gcormier/esphome-pressure/modules/hybrid/stackup.png

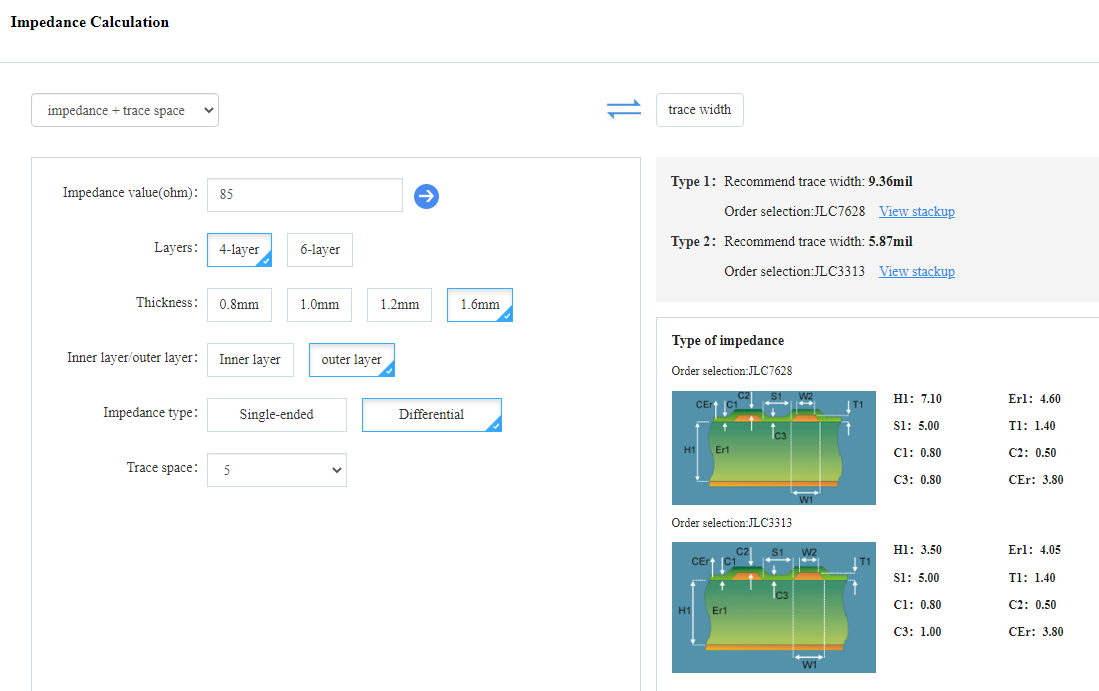
modules/hybrid/stackup.png
