gcormier/esphome-pressure/modules/hybrid/SDP810.step

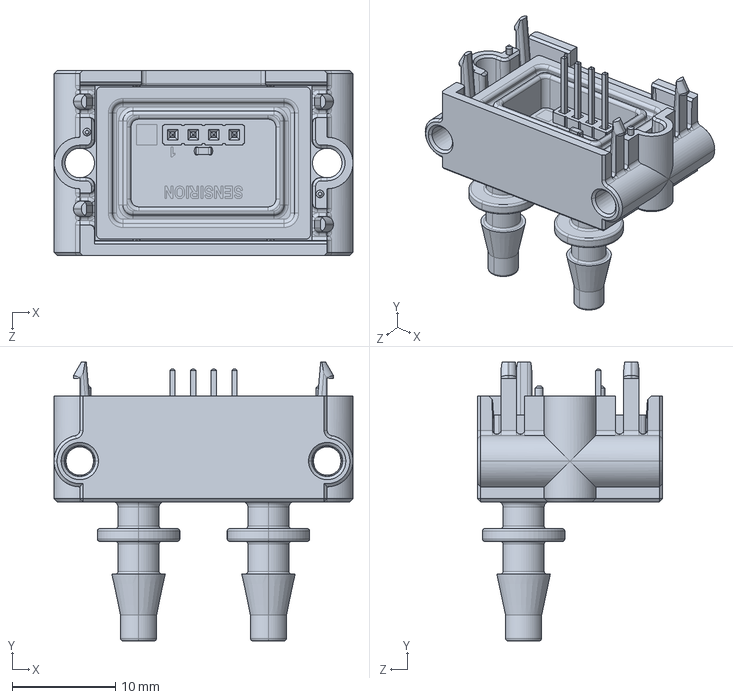
[picture p3: CAD file, 2026-10-07]
modules/hybrid/SDP810.step
29.0 x 27.1 x 18.0 mm
