gcormier/esphome-pressure/pcb/enclosurepanel/HoseSketch.dxf

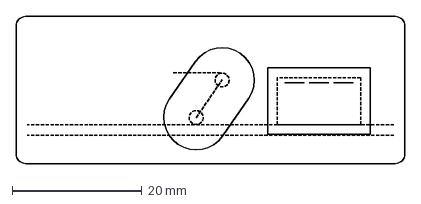
[picture p4: CAD file, 2024-12-11]
pcb/enclosurepanel/HoseSketch.dxf
60.0 x 22.7 mm
