gcormier/esphome-pressure/modules/hybrid/6899.STEP

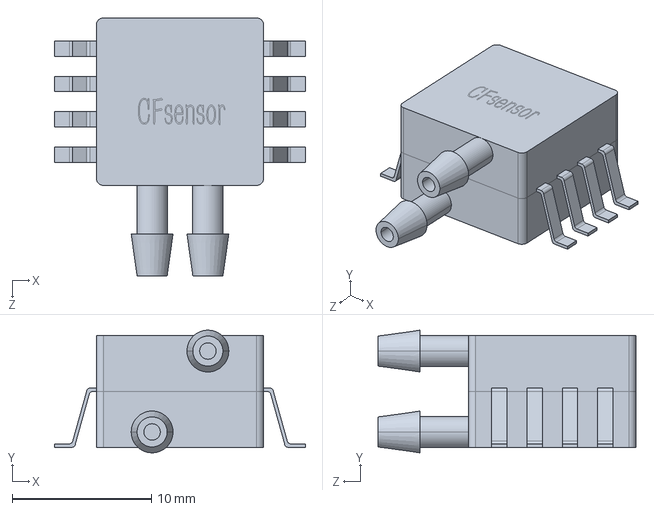
[picture p5: CAD file, 2023-09-27]
modules/hybrid/6899.STEP
18.0 x 8.80 x 18.5 mm
