gcormier/esphome-pressure/pcb/enclosurepanel/PowerSketch.dxf

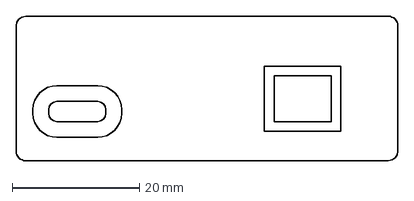
[picture p6: CAD file, 2024-12-11]
pcb/enclosurepanel/PowerSketch.dxf
60.0 x 22.7 mm
