gcormier/esphome-pressure/pcb/HC-SFP-20P--3DModel-STEP-56544.STEP

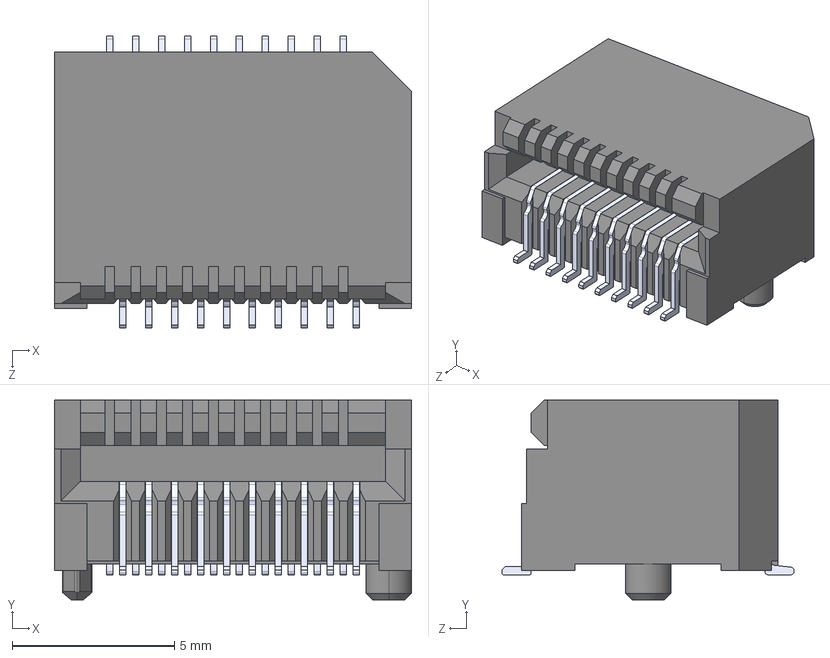
[picture p7: CAD file, 2026-10-07]
pcb/HC-SFP-20P--3DModel-STEP-56544.STEP
11.0 x 6.15 x 9.00 mm
HC-SFP-20P
pins^HC-SFP-20P Ass x 10
