gcormier/esphome-pressure/pcb/6897.STEP

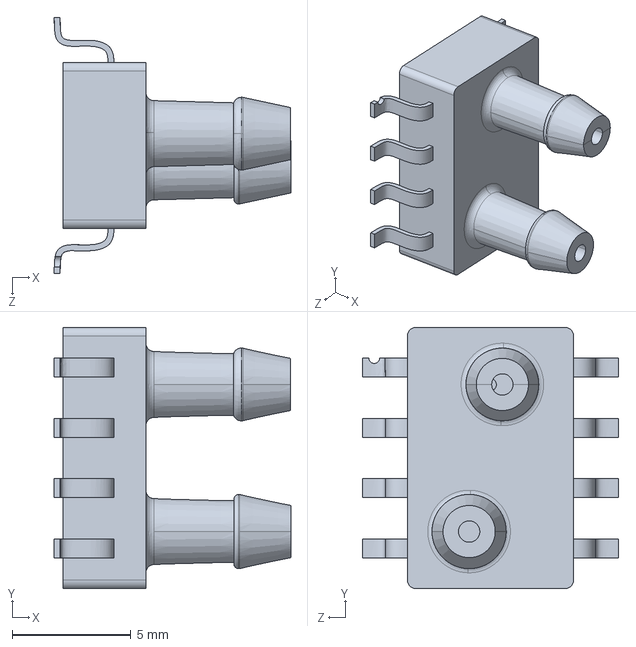
[picture p8: CAD file, 2023-09-27]
pcb/6897.STEP
9.97 x 11.0 x 10.8 mm
