gcormier/esphome-pressure/pcb/enclosurepanel/plate-power.dxf

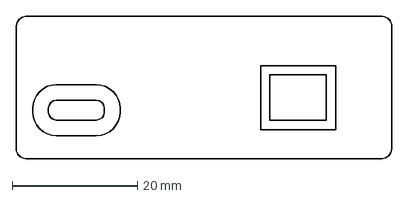
[picture p9: CAD file, 2023-12-01]
pcb/enclosurepanel/plate-power.dxf
60.0 x 22.7 mm
