gcormier/esphome-pressure/(threads)

Thread 3 (2024-04-25):

What size of tubing should be used?

LukeTowers, 2024-04-25:
What size of tubing is needed and do you have any recommendations for where to source it from?

gcormier, 2024-04-26:
The biggest part of the barb is 3mm in diameter. So if you are using a stiffer tuber, it should be close to that for the ID. If you are using a soft material, it can probably be a bit smaller.

I bought mine from homedepot - I would bring the device to your local store to see what fits best, I would hate to recommend something that doesn't fit :) I no longer have the packing for mine. it is a clear, fairly stiff, tube. Next time I would probably splurge on something softer like silicone perhaps, but it doesn't matter in the end since it is static pressure so there is no airflow.

kramttocs, 2024-07-15:
I ordered Pure Silicone Tubing 1/16 ID x 1/8 OD and it fit well.

gcormier, 2024-07-16:
Now covered in the readme - https://github.com/gcormier/esphome-pressure?tab=readme-ov-file#hosetubing

kramttocs, 2024-07-19:
Actually, I retract my 1/16 suggestion. It does work but it is tough to connect to the common 1/8 fittings.
Ordered this and it works much better:

Quickun Pure Silicone Tubing, 2mm ID x 4mm OD High Temp Food Grade Tube Pure Silicone Hose Tube for Home Brewing, Beer Line, Kegerator, Wine Making, Aquaponics, Air Hose by Proper Pour (16.4 Ft)

gcormier, 2024-07-20:
thx have modified readme

Closed 2024-07-16.

Thread 4 (2024-05-06):

I2C not reporting on Esphome?

benhoff, 2024-05-06:
Hey I have the following for the yaml with esphome:

``` yaml
i2c:
  sda: 6
  scl: 7
  scan: true
  id: bus_a

sensor:
  - platform: xgzp68xx
    temperature:
      name: "Pressure Temperature"
    pressure:
      name: "Pressure Diff pressure"
    update_interval: 5s
```

However, I'm not seeing the DP sensor in esphome/home assistant.
Are the pinout assignments on here correct or anything else I should look into?

gcormier, 2024-05-06:
That should work - what do the logs look like?

benhoff, 2024-05-06:
They look with the exception of not having an I2C sensor in them:

``` log
[I][app:029]: Running through setup()...
[C][wifi:038]: Setting up WiFi...
[C][wifi:051]: Starting WiFi...
[C][wifi:052]:   Local MAC: D4:F9:8D:09:D8:F0
[D][wifi:462]: Starting scan...
[W][component:157]: Component wifi set Warning flag: unspecified
[D][wifi:477]: Found networks:
[I][wifi:521]: - 'ShenHousehold' [redacted]▂▄▆█
[D][wifi:522]:     Channel: 1
[D][wifi:523]:     RSSI: -40 dB
[I][wifi:521]: - 'ShenHousehold' [redacted]▂▄▆█
[D][wifi:522]:     Channel: 11
[D][wifi:523]:     RSSI: -78 dB
[D][wifi:526]: - [redacted] [redacted]▂▄▆█
[D][wifi:526]: - [redacted] [redacted]▂▄▆█
[D][wifi:526]: - [redacted] [redacted]▂▄▆█
[D][wifi:526]: - [redacted] [redacted]▂▄▆█
[D][wifi:526]: - [redacted] [redacted]▂▄▆█
[D][wifi:526]: - [redacted] [redacted]▂▄▆█
[D][wifi:526]: - [redacted] [redacted]▂▄▆█
[D][wifi:526]: - [redacted] [redacted]▂▄▆█
[D][wifi:526]: - [redacted] [redacted]▂▄[D][wifi:526]: - [redacted] [redacted][D][wifi:526]: - [redacted] [redacted]▂▄▆█
[D][wifi:526]: - [redacted] [redacted]▂▄ [D][wifi:526]: - [redacted] [redacted]▂▄▆█
[D][wifi:526]: - [redacted] [redacted]▂▄▆█[D][wifi:526]: - [redacted] [redacted][D][wifi:526]: - [redacted] [redacted]▂▄▆█
[D][wifi:526]: - [redacted] [redacted]▂▄▆█
[D][wifi:526]: - [redacted] [redacted]▂▄▆█
[D][wifi:526]: - [redacted] [redacted]0;36m[D][wifi:526]: - [redacted] [redacted] [D][wifi:526]: - [redacted] [redacted]▂▄▆█
[D][wifi:526]: - [redacted] [redacted]▂▄0;36m[D][wifi:526]: - [redacted] [redacted]▂▄▆█
[D][wifi:526]: - [redacted] [redacted][D][wifi:526]: - [redacted] [redacted]▂▄▆█
[D][wifi:526]: - [redacted] [redacted]▂▄�
[D][wifi:526]: - [redacted] [redacted]▂▄▆█
[D][wifi:526]: - [redacted] [redacted][D][wifi:526]: - [redacted] [redacted][D][wifi:526]: - [redacted] [redacted][I][wifi:303]: WiFi Connecting to 'ShenHousehold'...
[W][wifi_esp32:482]: Event: Disconnected ssid='ShenHousehold' bssid=[redacted] reason='Auth Expired'
[W][wifi:633]: Error while connecting to network.
[D][wifi:677]: Retrying with hidden networks...
[I][wifi:303]: WiFi Connecting to 'ShenHousehold'...
[I][wifi:597]: WiFi Connected!
[C][wifi:408]:   Local MAC: D4:F9:8D:09:D8:F0
[C][wifi:413]:   SSID: [redacted]
[C][wifi:416]:   IP Address: 192.168.1.108
[C][wifi:420]:   BSSID: [redacted]
[C][wifi:421]:   Hostname: 'hvac'
[C][wifi:423]:   Signal strength: -42 dB ▂▄▆█
[C][wifi:427]:   Channel: 1
[C][wifi:428]:   Subnet: 255.255.255.0
[C][wifi:429]:   Gateway: 192.168.1.1
[C][wifi:430]:   DNS1: 192.168.1.62
[C][wifi:431]:   DNS2: 192.168.1.182
[D][wifi:606]: Disabling AP...
[C][ota:096]: Over-The-Air Updates:
[C][ota:097]:   Address: hvac.local:3232
[C][ota:100]:   Using Password.
[C][ota:103]:   OTA version: 2.
[C][api:025]: Setting up Home Assistant API server...
[I][app:062]: setup() finished successfully!
[W][component:170]: Component wifi cleared Warning flag
[W][component:157]: Component api set Warning flag: unspecified
[I][app:100]: ESPHome version 2024.4.2 compiled on May  4 2024, 20:00:15
[C][wifi:580]: WiFi:
[C][wifi:408]:   Local MAC: D4:F9:8D:09:D8:F0
[C][wifi:413]:   SSID: [redacted]
[C][wifi:416]:   IP Address: 192.168.1.108
[C][wifi:420]:   BSSID: [redacted]
[C][wifi:421]:   Hostname: 'hvac'
[C][wifi:423]:   Signal strength: -40 dB ▂▄▆█
[C][wifi:427]:   Channel: 1
[C][wifi:428]:   Subnet: 255.255.255.0
[C][wifi:429]:   Gateway: 192.168.1.1
[C][wifi:430]:   DNS1: 192.168.1.62
[C][wifi:431]:   DNS2: 192.168.1.182
[C][logger:166]: Logger:
[C][logger:167]:   Level: DEBUG
[C][logger:169]:   Log Baud Rate: 115200
[C][logger:170]:   Hardware UART: USB_CDC
[C][captive_portal:088]: Captive Portal:
[C][mdns:115]: mDNS:
[C][mdns:116]:   Hostname: hvac
[C][ota:096]: Over-The-Air Updates:
[C][ota:097]:   Address: hvac.local:3232
[C][ota:100]:   Using Password.
[C][ota:103]:   OTA version: 2.
[C][api:139]: API Server:
[C][api:140]:   Address: hvac.local:6053
[C][api:142]:   Using noise encryption: YES
[D][api:102]: Accepted 192.168.1.101
[W][component:170]: Component api cleared Warning flag
[D][api.connection:1210]: Home Assistant 2024.5.2 (192.168.1.101): Connected successfully
```

gcormier, 2024-05-06:
Can you set the esphome logger to debug so we can see if it's scanning the i2c bus and what's happening?

benhoff, 2024-05-07:
Weird, setting the logger triggered the sensor to update.
I must have had some cached build files with invalid settings and rebuilding with debug must have cleared the cache.

Thanks for the sweet device!

gcormier, 2024-05-07:
Awesome glad it is working :) Let me know how you end up using it - would be great to add more examples and use-cases to the repo.

Closed 2024-05-07.

Thread 5 (2024-07-15):

Not reading the correct value

kramttocs, 2024-07-15:
Posted on the forum but figure better to do so here.

Using mine for a radon fan so one port is left open and the other connected to the suction pipe of the fan system.
Online seems like radon fans should be well under 2". With .5" being the most common I see. Prior to ordering, confirmed mine was .8" to be sure it was safely under the 2" limit.

Using the same drilled hold in the suction pipe, my analog u tube shows .8" WC and my digital manometer show .77-.85". Switching the manometer to kpa shows 0.2kPa.

Hooking up the sensor after zeroing it out and leaving one port open is .43 to .45 kPa.
This would be 1.77".
Am I missing something?
That’s pushing the 2" hard and I don’t want to break it but at the same time, it really shouldn’t be that close so not sure what’s going on.

gcormier, 2024-07-15:
Did you try switching ports? One is marked low pressure the other high. Not sure if they truly have much effect on readings or not.

kramttocs, 2024-07-15:
Hey. I wondered the same so I did actually. Both read the exact same (so that's good as far as consistency goes :) ).
I know in your post on the HA forum you mentioned being more concerned with changes from the norm more than what the actual numerical norm is but if you connect/compare it to your manometer, does it read the same?

kramttocs, 2024-07-16:
I hooked it to my air handler (planning to order another for permanent if we can figure out this out) and still got way higher than my manometer.  Let me know if there is another way to test.

gcormier, 2024-07-16:
I'll need some time to figure out a way to test, and I'll test a few units. Can you share your YAML here for the sensor section?

kramttocs, 2024-07-16:
Thanks! If there's a baseline you come up with where I can test also, let me know. The analog u tube was the best I could come up with.
Here you go:

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

gcormier, 2024-07-16:
Can you provide me the laser marking code on the sensor itself? Should be
something like 6899001Dxxxx

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

kramttocs, 2024-07-16:
Here you go:
6899001DF441

gcormier, 2024-07-16:
Thanks. I've tested different markings and gotten consistent results, so I think the laser markings are a data or lot code. I've ordered some T-fittings and more tube to be able to test simultaneous devices and will report back.

I'm gonna leave this issue open until we confirm it was either shipping damage or something else.

gcormier, 2024-07-22:
I did some testing. `k_value` is supposed to be `8192` for the +/- 0.5kPa sensors. Can you let me know if that helps?

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

kramttocs, 2024-07-22:
Great! It will probably be this evening before I can but the fact that it would be double originally sounds spot on for what I was seeing.

kramttocs, 2024-07-23:
Looks like we are in business. The readings are halved and much more inline with my manometer. Excellent find!

Closed 2024-07-23.

Thread 6 (2024-07-20):

Feature suggestions: Expose GPIO

jmtorres, 2024-07-20:
A few additional features would make this an amazing All in one Air Handler monitoring device:

1. 1-wire interface to connect DS18B20, DHT22, and other Temperature and/or Humidity sensors.
2. Optocoupled / isolated 24VAC inputs to monitor float switches and call status.
3. Relay outputs to override thermostat.

I had originally planned to use an older [Shelly UNI board](https://kb.shelly.cloud/knowledge-base/shelly-uni) which can handle 24vac power and 2x 24vac inputs. However, it'd be missing the pressure sensor.

Some inspiration: https://www.youtube.com/watch?v=Hv6urCTRV70

gcormier, 2024-07-20:
I've got a couple of the foundational pieces already, so perhaps a project for winter 24/25. Relay outputs does not interest me since they must be a dime a dozen from Ali. I wonder if there are any sort of module standard pinouts for these.

jmtorres, 2024-07-21:
The relay output hasn't been high on my list for this project, but the others are essential in my book. If the a esptemp8c had the differential pressure sensor and some 24vac capable inputs, that would be an ideal device.

I have a few PMS sensors running on AirGradient and ESPHome. Have you used them within or near an air handler? I'm under the impression that it's not ideal near turbulent air.

gcormier, 2024-07-21:
I'm not a big fan of the PMS sensors. I've have much better results with the Panasonic GCJA. I have two in my ducts and they work great. Both are designed for industrial equipment monitoring so perhaps that helps?

afallows, 2024-10-24:
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

This comment resonates with me as well. A couple 24VAC capable inputs, a couple relay outputs and a couple temperature inputs would make this the perfect smart HVAC device.

gcormier, 2024-10-24:
I wonder if I could kickstart it or something. Making the design is trivial, it's more a question of having a bunch of boards sitting around that nobody is buying. I think I have old designs that I never even made with those exact requirements.

I'm not sure about relay outputs though - those are pretty cheap commodity items on the usual suspects... it might add extra cost, but I guess it's the usual Lada/Civic/BMW conundrum and I'm often aiming for the last option when designing these things as I like a neat and well designed option instead of things that look like bombs around the house :)

jmtorres, 2024-10-24:
As you can see on the HA subreddit, there is some interest. What is the smallest run that would be feasible?

This is my current rigged up solution with the Shelly UNI. This handles the additional features I mentioned, excluding the pressure differential sensor. It'd definitely not pretty or ideal. Although it does have 24VAC capable isolated outputs, the current rating doesn't seem to be enough for an HVAC contactor.

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

gcormier, 2024-10-25:
Relays add a few $ for parts, fees and bigger power section to power said relays. (Solid state relays wouldn't be ideal in this application - they can sometimes leak a tiny current, which is enough for something digital on the other end to interpret "on")

Optos another few $ in parts and fees. Bigger PCB to fit all of those, and pluggable headers. Switch the ESP32 from a C3-MINI to one with more GPIO's to control all those.

For the small runs I'm doing it might increase the cost about 15$ per? I'd have to do the design to find out.

afallows, 2024-11-11:
Just ordered a new style board from you but put in the wrong address by one digit. 9131 should be 9135. Trying to figure out how to fix it

rewardone, 2024-11-11:
I had this on my waitlist. Cool to see a breakout for temperature probes. This was the next thing I was looking at monitoring after pressure. With the breakouts, I assume I should be able to add two probes like these [adafruit ones](https://www.digikey.com/en/products/detail/adafruit-industries-llc/381/5875807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) for differential temperature?

Adding additional relays could be cool, but I don't know how large the market is. A $150-$200 price is battling a thermostat.
As a monitoring and accessory control device, it would be interesting. I ask HVAC contractors about powering my 3 accessories from a single source and they think I'm crazy (humidifier, dehumidifier, ERV/fan).

gcormier, 2024-11-11:
Yup you can use those sensors, check out https://github.com/gcormier/esptemp8c for more info. Didn't hardware but same process for 1 wire

gcormier, 2024-12-10:
Design now breaks out a few GPIOs.

Closed 2024-12-10.

Thread 8 (2024-11-19):

Add information about optimal placing of tubes for HVAC filter

ForceConstant, 2024-11-19:
I would like to use this device for measuring health of HVAC filter, and don't know anything about where the tubes should be located. i.e. does it have to be right in front/behind filter? Does it have to be in center, or can it be just off the edge, etc?

gcormier, 2024-11-20:
There is optimal placement with pitot tubes to minimize the effect of the airflow on the pressure reading.  eg https://www.amazon.ca/Fieldpiece-Static-Pressure-Probes-Manometers/dp/B0039UHM9U

That said, I think as long as they are in the same place you're hopefully going to get similar readings to see the relative information.

If someone more qualified wants to contribute info, happy to merge.

drew-hill, 2025-01-17:
Love your tubing suggestions. Do you have barbed fittings that you like for connecting the unit to an air handler?

gcormier, 2025-01-17:
Nope. Personally I just jam my tubes in the ducts. I find the pitot tubes brutally expensive for what they are.

drew-hill, 2025-01-17:
> Nope. Personally I just jam my tubes in the ducts. I find the pitot tubes brutally expensive for what they are.

Hah! Do they seem to work reasonably well that way? I've found some magnetic pitot tubes on amazon for ~$13 USD in the US.

gcormier, 2025-01-18:
That's a good price! Let me know how it goes and we can update some info to share as well. It seems to work fine for me but I don't have a comparison. I do have some pitot tubes from my manometer so I could try those sometime if I dig them out.

Cellivar, 2025-03-05:
Sliding in with some updated information I've learned. For filter pressure differential in particularly we're looking for static pressure. A pitot tube is for dynamic pressure and isn't useful for just filter loading. [A good thread.](https://sawmillcreek.org/showthread.php?293302-Pitot-Tube-Location-for-Filter-Monitoring) Some specific nuggets:

> To improve the accuracy and account for any flow/pressure changes on the exit side downstream of the filter you can connect the other leg of the manometer to the exit of your filter. This is a differential pressure measurement.

> A rule of thumb is no direction or flow disturbance 10 pipe diameters (hydraulic diameter for non-round) prior to the measurement point t and 5 pipe diameters past the measurement point.
In the end you’re just looking to get a relative measurement and much less than these ideal conditions needed. Try to use these distances as a rough estimate but not at the expense/effort of changing things drastically.

> Please note it is perpendicular meaning don’t put a tube or port facing the flow stream. Just put it in the side wall of the pipe and not projected into the pipe. There are inaccuracies that can happen from how you put the port in. The smaller the better with minimal to no intrusions into the flow stream.

> ASHRAE spec requires that [a static pressure probe port on a duct] be flush with the wall.

> I backed the fitting out as far as I could and still maintain a seal. Turns out it does matter. The reading went up exactly 0.2".

> fwiw, relative flow is proportional to the squareroot of one minus the ratio of the change in pressure to the total internal fan pressure. So let's say for a give system configuration your filter pressure changes from .3" to 3.3". IRRC, that DC has an internal pressure of about 15" so 1-3/15 = .8 and the squareroot of .8 is about .9, so about a 10% reduction for a 3" increase. You would not likely notice a 10% change in flow when it happens gradually over time.

> One thing to be aware of with measuring the pressure drop across the filter is that the resistance in the rest of the flow network affects flow and thus the measurement. You want to take a reading at some reference condition most likely with all blast gates open. This condition gives the greatest flow and greatest pressure drop across the filter. You take a reading with filter clean (new is good).

My takeaway is my differential probe installation should be two flush ports on either side of my filter on the ductwork, preferably 3 feet away from the filter or other changes to airflow (within practical limits). I will take a baseline measurement with a clean filter and all vents wide open, a second with the vents set normally, and will compare those readings to measurement over time to determine filter loading.

Thread 18 (2025-07-22):

Dual sensor version?

dcorwin8222, 2025-07-22:
Can we get a dual sensor version of this device? I already have one that measures the drop across the filter. Would like a second to measure ESP.

gcormier, 2025-07-29:
I think the easiest solution is just to use a 2nd device.

Closed 2025-07-29.
