gcormier/esphome-pressure/(commit log)

2023-10-09 layers and edgecuts for signal improvements
    [esphome-pressure.kicad_pcb]
2023-12-01 panels for hammond enclosure
    [panel1-B_Cu.gbr, panel1-B_Mask.gbr, panel1-B_Paste.gbr, panel1-B_Silkscreen.gbr, panel1-Edge_Cuts.gbr, panel1-F_Cu.gbr, panel1-F_Mask.gbr, panel1-F_Paste.gbr]
2023-12-01 remove keep upright property
    [esphome-pressure.kicad_pcb]
2023-12-01 rail space
2024-07-16 tubing size recommendation
2024-07-20 more feedback on tubes
2024-08-01 fix copper pour
    [esphome-pressure.kicad_pcb]
2024-10-28 some updates
    [esphome-pressure.kicad_pcb, esphome-pressure.kicad_sch]
2024-12-10 sneak in temp header
    [esphome-pressure.kicad_pcb, esphome-pressure.kicad_sch]
2024-12-11 new render add pullup
    [HoseSketch.dxf, PowerSketch.dxf, esphome-pressure.kicad_pcb, esphome-pressure.kicad_sch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]
2025-01-06 update config for temp sensor
2025-03-01 single/absolute pressure notes
2025-09-15 touch and store
    [esphome-pressure.kicad_pcb, esphome-pressure.kicad_sch]
2026-09-29 Add SDP810 footprint with 3D model reference
2026-09-29 Add SDP810 symbol, 3D model, datasheet and project library tables
    [SDP810.step]
2026-09-29 KiCad 10 project settings upgrade
2026-09-29 Move XGZP6899 module to modules/xgzp6899, footprints to interface/
    [6899.STEP, xgzp6899.kicad_pcb, xgzp6899.kicad_sch]
2026-09-29 Flatten breakout carrier into carriers/breakout, share SFP+ footprint via interface/
    [HC-SFP-20P--3DModel-STEP-56544.STEP, sensor_module_carrier.kicad_pcb, sensor_module_carrier.kicad_sch]
2026-09-29 Rename projects, matrix CI across boards, interface spec and readme
    [breakout.kicad_pcb, breakout.kicad_sch]
2026-09-29 Point sensor_module footprint library at shared interface/
2026-09-29 Add sensor_module repo as submodule for the shared SFP interface library
2026-09-29 Register shared sensor_module footprint library
2026-09-29 Add SDP810 module (schematic; PCB still the XGZP copy)
    [SDP810.step, sdp810.kicad_pcb, sdp810.kicad_sch]
2026-09-29 SDP810 module PCB (L42) and module length scheme
    [sdp810.kicad_pcb]
2026-09-29 Add SensorModule interface symbol, show it on module schematics
    [sdp810.kicad_sch, xgzp6899.kicad_sch]
2026-09-29 Register SensorModule interface symbol library
2026-09-29 INTERFACE: document SensorModule symbol
2026-09-29 Interface: add SPI, UART, INT and spares; C2M/M2C naming that keeps SFP pin directions
    [sdp810.kicad_sch, xgzp6899.kicad_sch]
2026-09-29 Bump sensor_module: SPI/UART interface pins
2026-09-29 SensorModule symbol: widen body so pin names don't overlap
    [sdp810.kicad_sch, xgzp6899.kicad_sch]
2026-09-29 Bump sensor_module: wider SensorModule symbol
2026-09-29 Interface naming: controller/peripheral (C2P/P2C) to match COPI/CIPO
    [sdp810.kicad_sch, xgzp6899.kicad_sch]
2026-09-29 Bump sensor_module: C2P/P2C naming
2026-09-29 SensorModule symbol: stacked VDD/GND pins per KLC S4.3
    [sdp810.kicad_sch, xgzp6899.kicad_sch]
2026-09-29 Bump sensor_module: stacked power pins
2026-09-29 Interface: +5V on pins 9 and 13, VDD renamed +3V3
    [sdp810.kicad_sch, xgzp6899.kicad_sch]
2026-09-29 Bump sensor_module: +3V3/+5V supplies
2026-09-30 Modules: SensorModule symbol replaces stock SFP+ as J1; VDD renamed +3V3; MOD_ABS tied to GND
    [sdp810.kicad_sch, xgzp6899.kicad_sch]
2026-09-30 Bump sensor_module: modules use SensorModule J1
2026-09-30 Prepare sensor_module for merge into esphome-pressure
2026-09-30 Drop sensor_module submodule
2026-09-30 Single repo: main board uses ../interface, module CI workflow, readme section
    [sdp810.kicad_sch, xgzp6899.kicad_sch]
2026-10-06 Hybrid sensor module, SDP810 screw mounts (interface-v3), main board J6 adoption
    Hybrid module (modules/hybrid): one L42 board that takes either an SDP810 (U1)
    or an XGZP6899D (U2) on a shared site at 22 mm; fit one, never both. The SDP810
    is screwed down through its body bores (M2x14, Ø2.2 NPTH) into carrier nuts at
    10 and 34 mm, with B-side keepouts there. J2 is a bottom-side 1x5 pogo test pad
    row, GND-SCL-3V3-SDA-GND, so a reversed jig only swaps SDA/SCL. Corners R1.
    Interface v3: carrier nuts at 2.925, 10, 34 and 40 mm; the 30 mm nut is gone
    (it overlaps 34 mm), which retires L32 and the xgzp6899 module. New shared
    footprint sensor_module:TestPads_1x05_P2.54mm. Skeleton keepouts moved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
    [6899.STEP, HC-SFP-20P--3DModel-STEP-56544.STEP, SDP810.step, breakout.kicad_pcb, breakout.kicad_sch, esphome-pressure.kicad_pcb, esphome-pressure.kicad_sch, hybrid.kicad_pcb]
2026-10-06 Remove the sdp810 and xgzp6899 modules; hybrid covers both sensors
    [6899.STEP, SDP810.step, sdp810.kicad_pcb, sdp810.kicad_sch, xgzp6899.kicad_pcb, xgzp6899.kicad_sch]
2026-10-06 Module CI: checkout v7 (Node 24), pin ubuntu-24.04
2026-10-07 Main board: LCSC C137948 for R2/R6 (C25130 short), C2897291 for J6; standoff note for interface-v3; refill zones
    [esphome-pressure.kicad_pcb, esphome-pressure.kicad_sch]
2026-10-07 Modules: write the gerber zip to JLCPCB/ so releases don't publish fab files
